vicentecunha/RS232Multiplexer/schematics/RS232Multiplexer.pdf

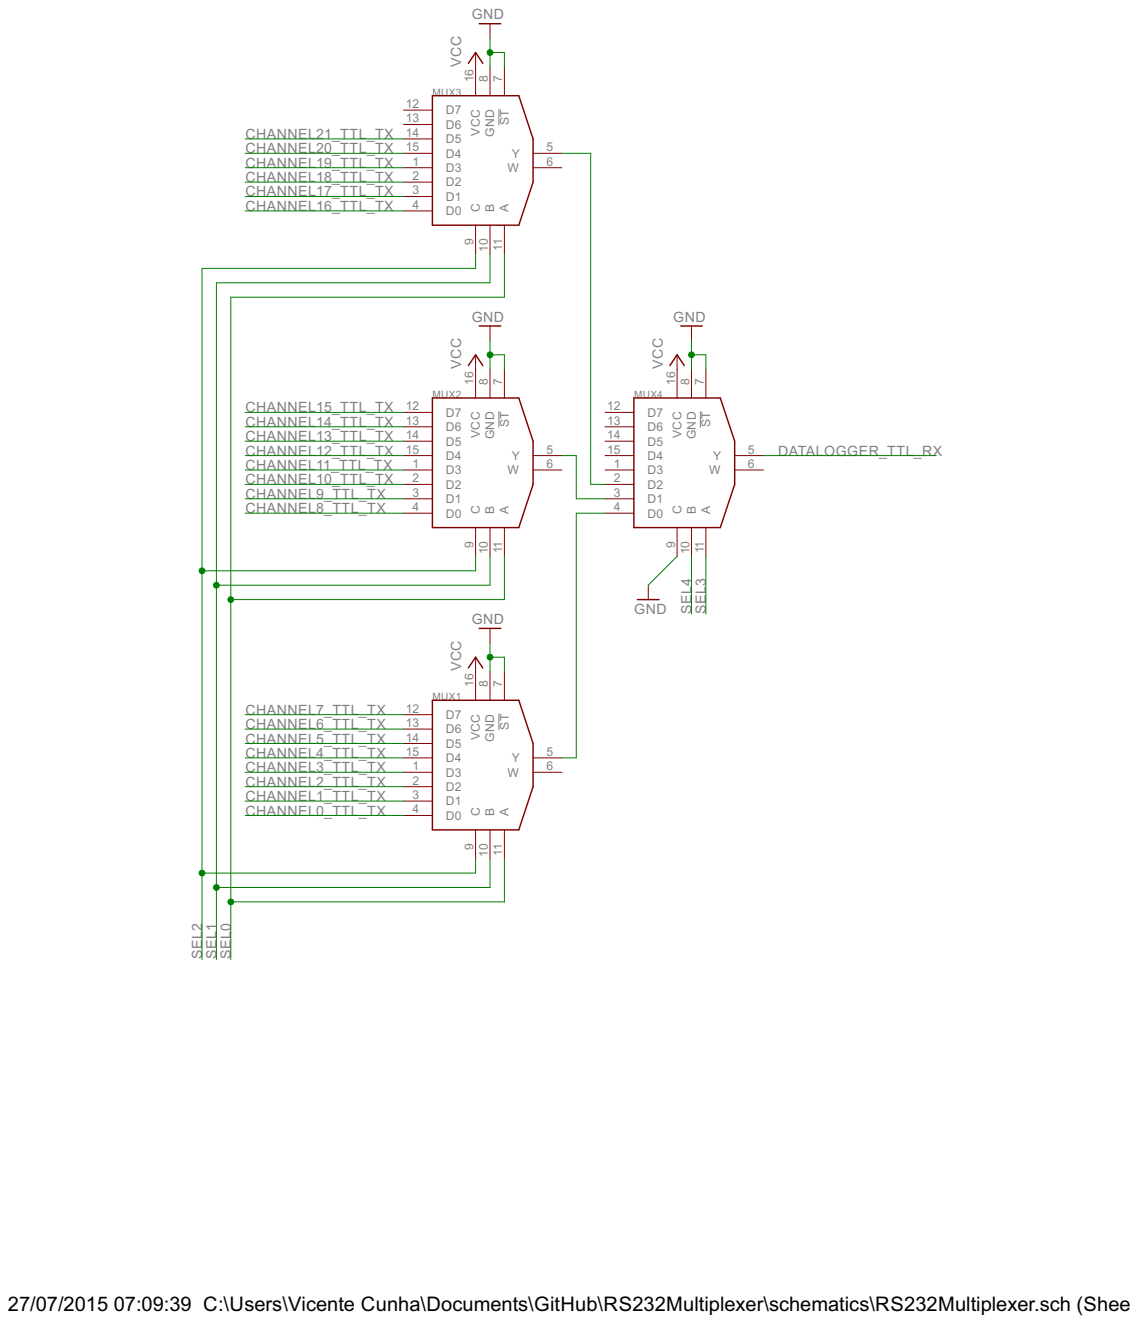
[picture p1: page 1]

27/07/2015 07:09:39 C:\Users\Vicente Cunha\Documents\GitHub\RS232Multiplexer\schematics\RS232Multiplexer.sch (Sheet: 1/4)

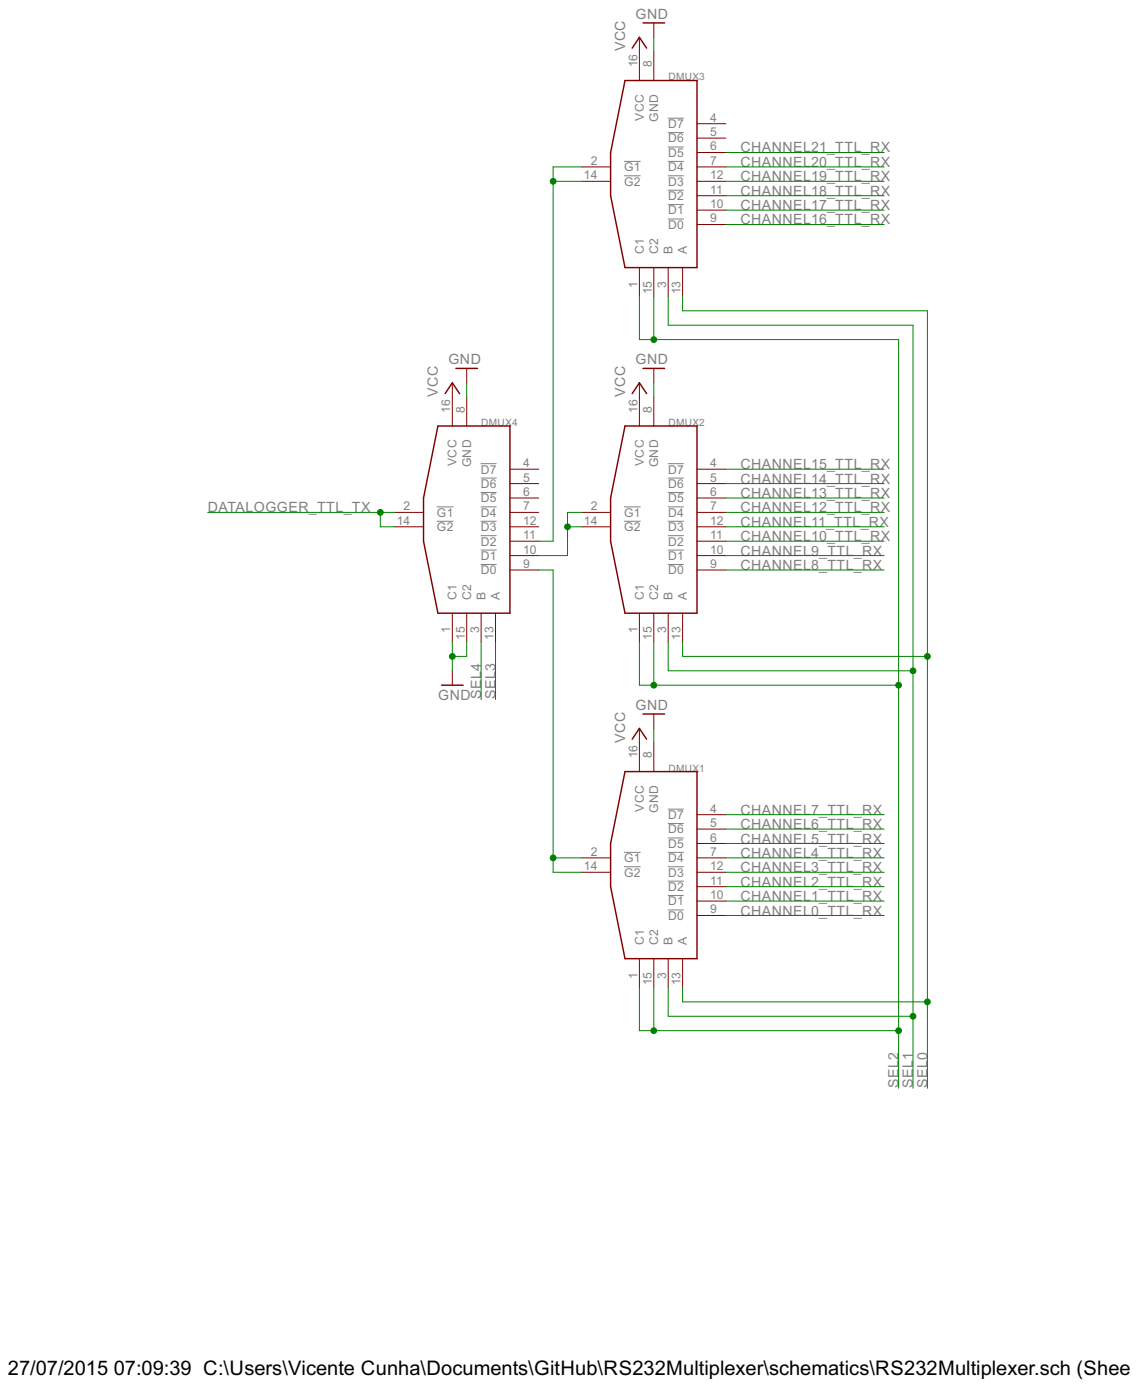
[picture p2: page 2]

27/07/2015 07:09:39 C:\Users\Vicente Cunha\Documents\GitHub\RS232Multiplexer\schematics\RS232Multiplexer.sch (Sheet: 2/4)

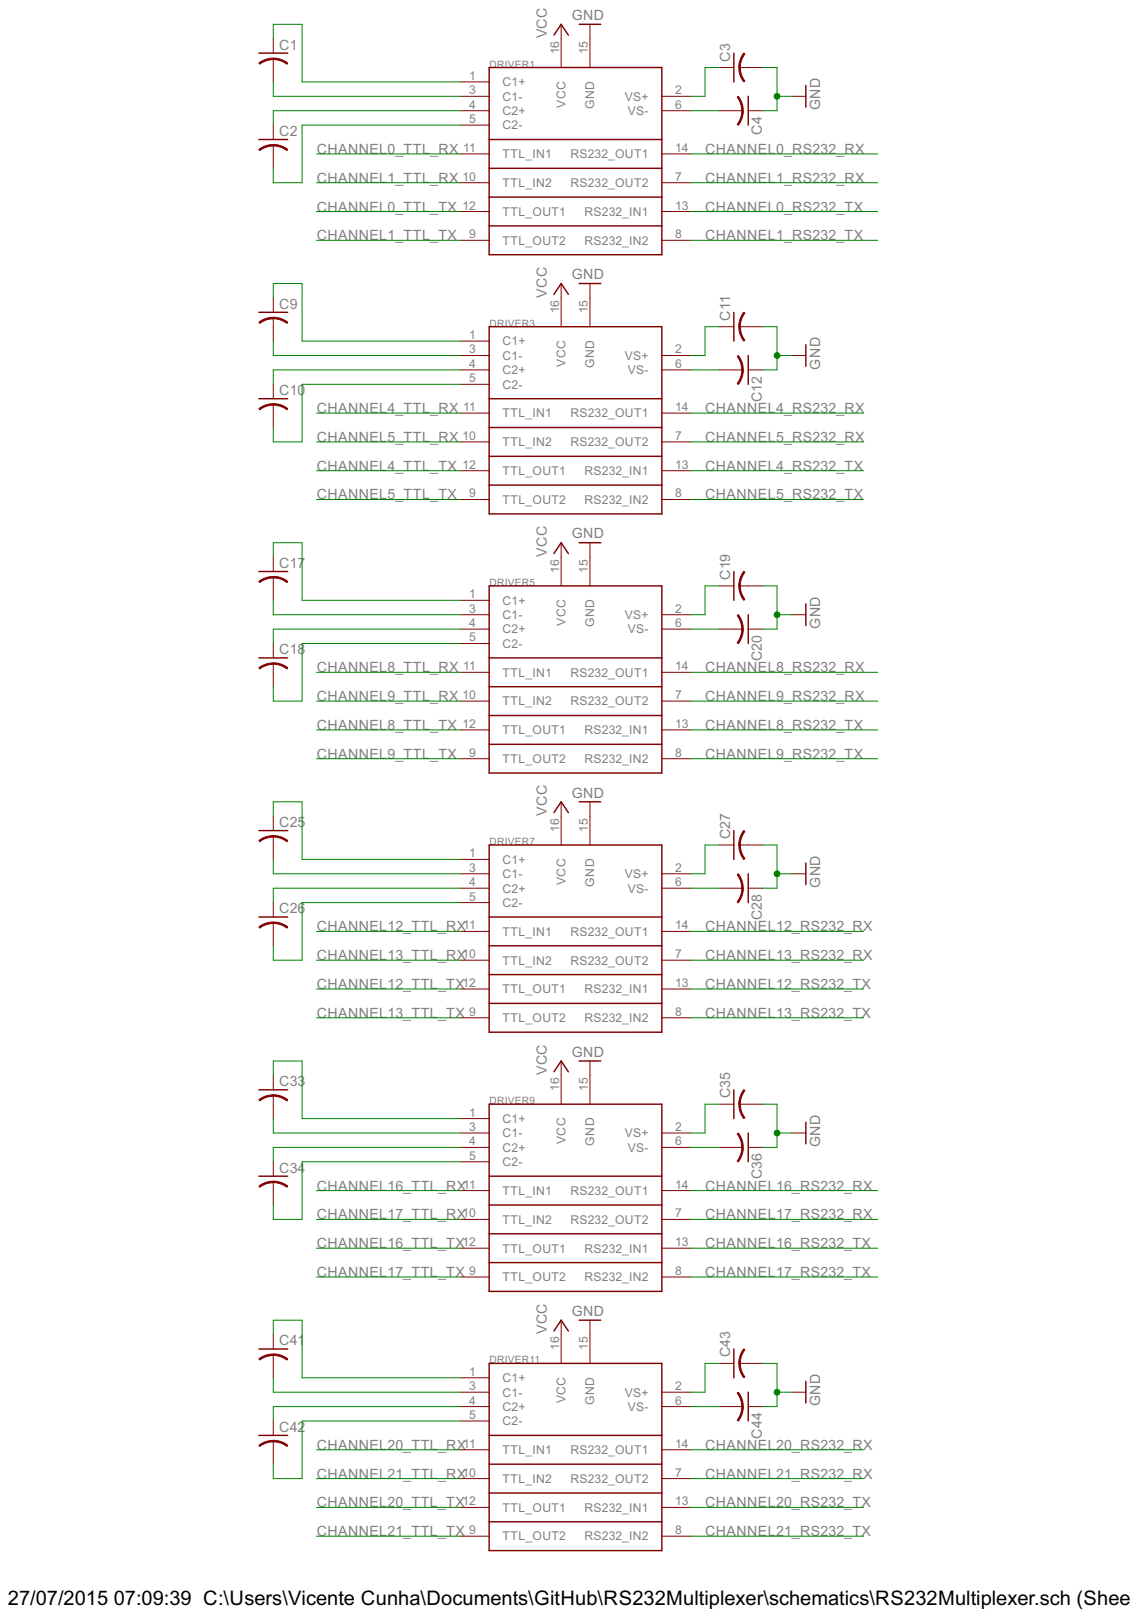
[picture p3: page 3]

27/07/2015 07:09:39 C:\Users\Vicente Cunha\Documents\GitHub\RS232Multiplexer\schematics\RS232Multiplexer.sch (Sheet: 3/4)

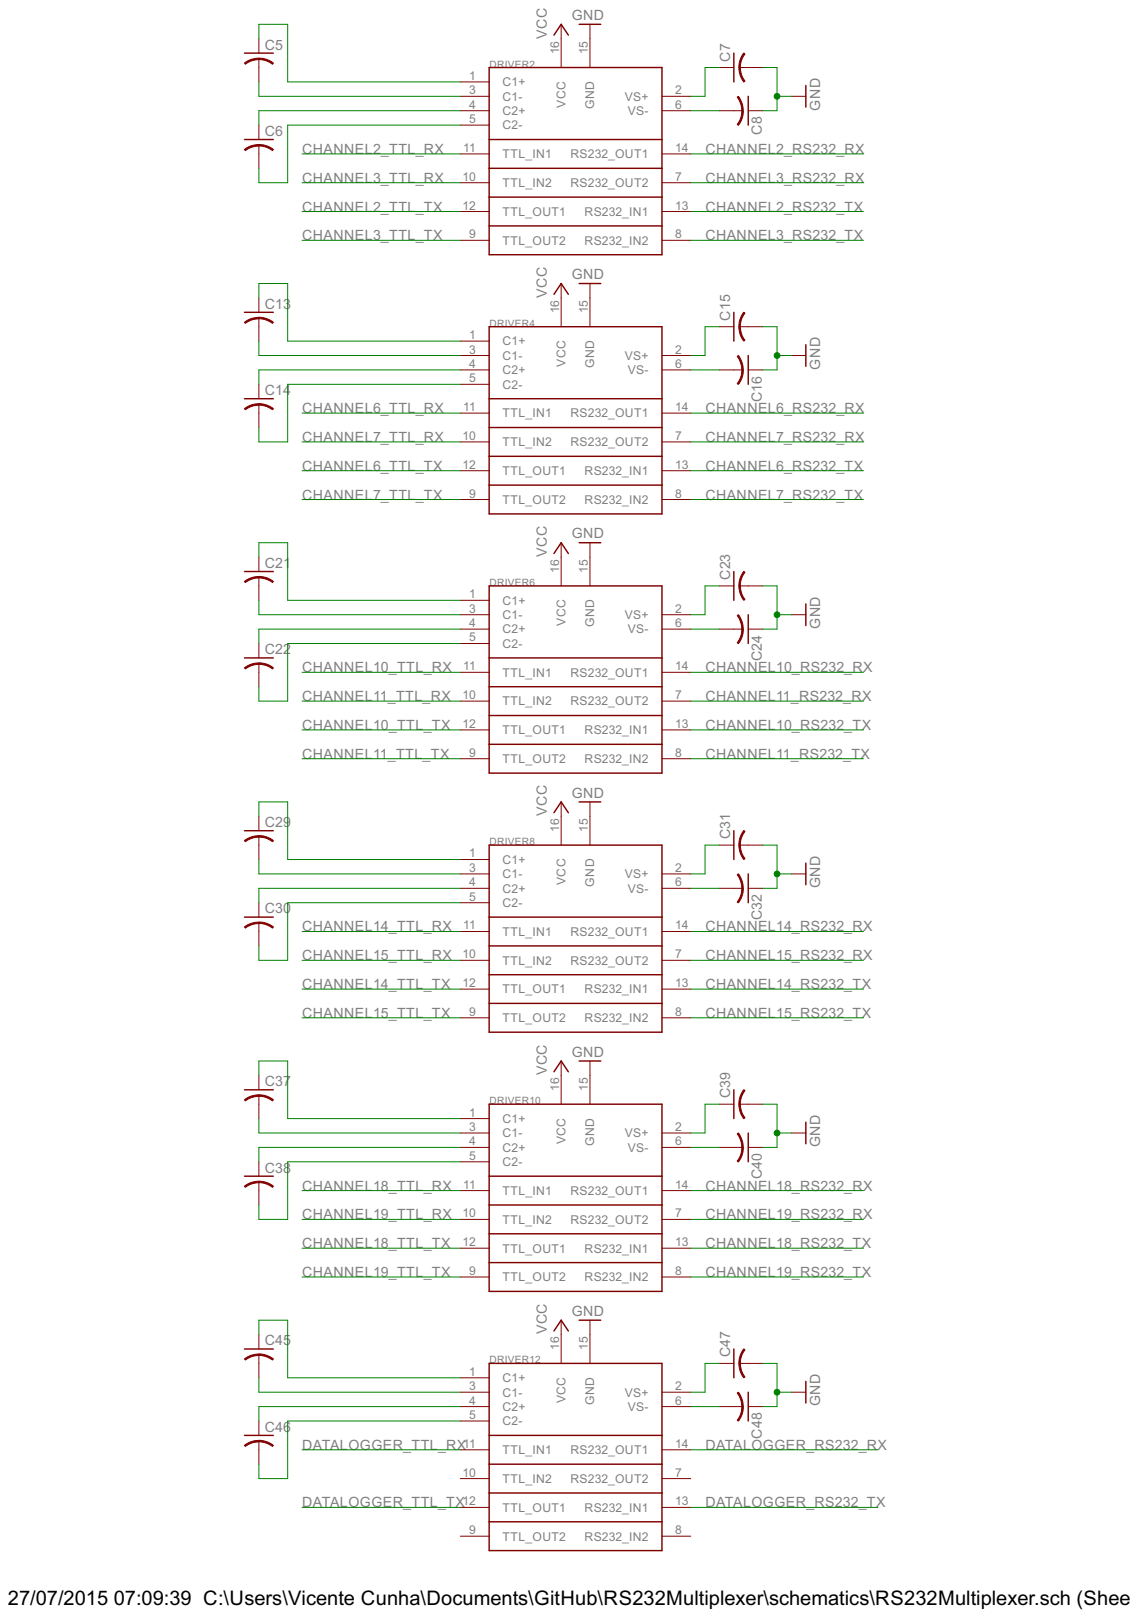
[picture p4: page 4]

27/07/2015 07:09:39 C:\Users\Vicente Cunha\Documents\GitHub\RS232Multiplexer\schematics\RS232Multiplexer.sch (Sheet: 4/4)
