vicentecunha/RS232Multiplexer/(commit log)

2015-07-27 Added eagle files and PDF schematic.
    [RS232Multiplexer.sch]
2015-07-27 Corrected wire node in dmux sheet.
    [RS232Multiplexer.sch]
